MechEngineerDhruv/dep-evtol-digital-twin/Drawings/Load Cell Diagram.png

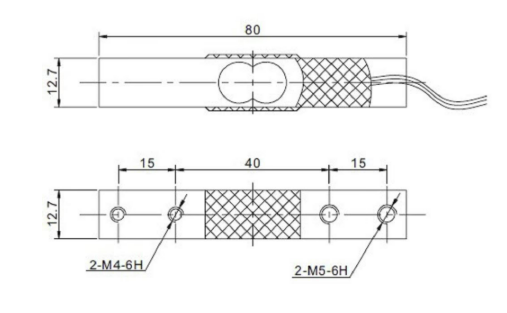
Drawings/Load Cell Diagram.png
