MechEngineerDhruv/dep-evtol-digital-twin/Schematics/ESP32 Pinouts.jpg

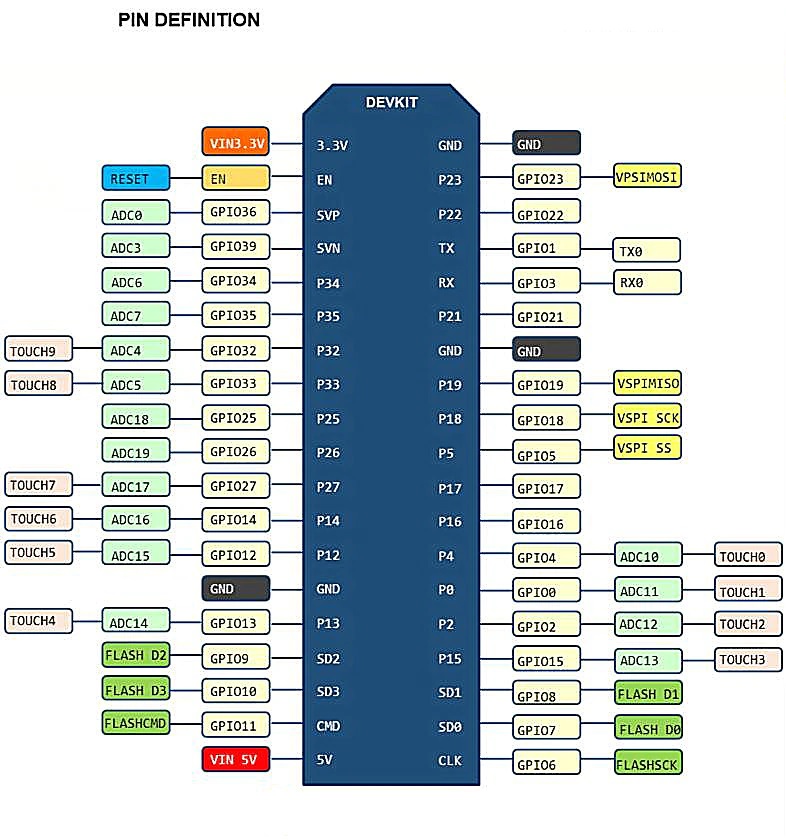
Schematics/ESP32 Pinouts.jpg
