MechEngineerDhruv/dep-evtol-digital-twin/Schematics/Load Cell Connections .png

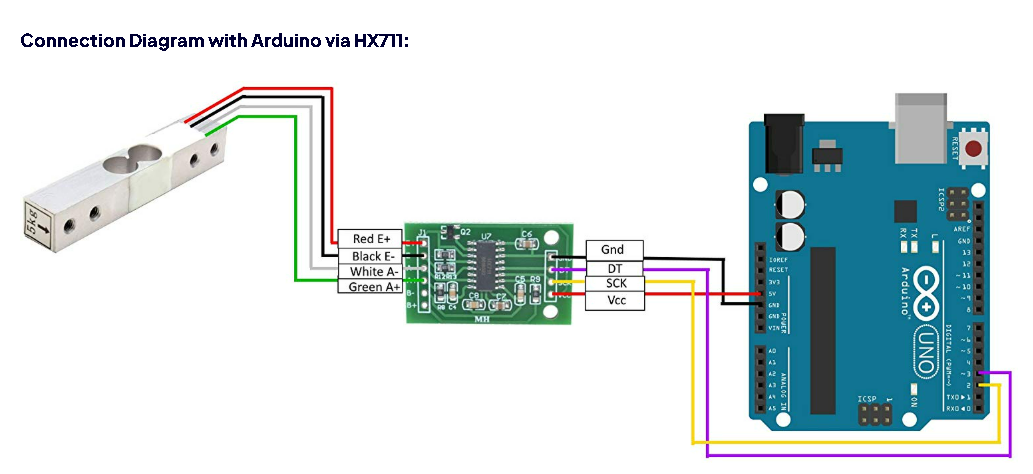
Schematics/Load Cell Connections .png
