MechEngineerDhruv/dep-evtol-digital-twin/Schematics/SCH_Main Schematic DTI_1-P1_2026-10-10.png

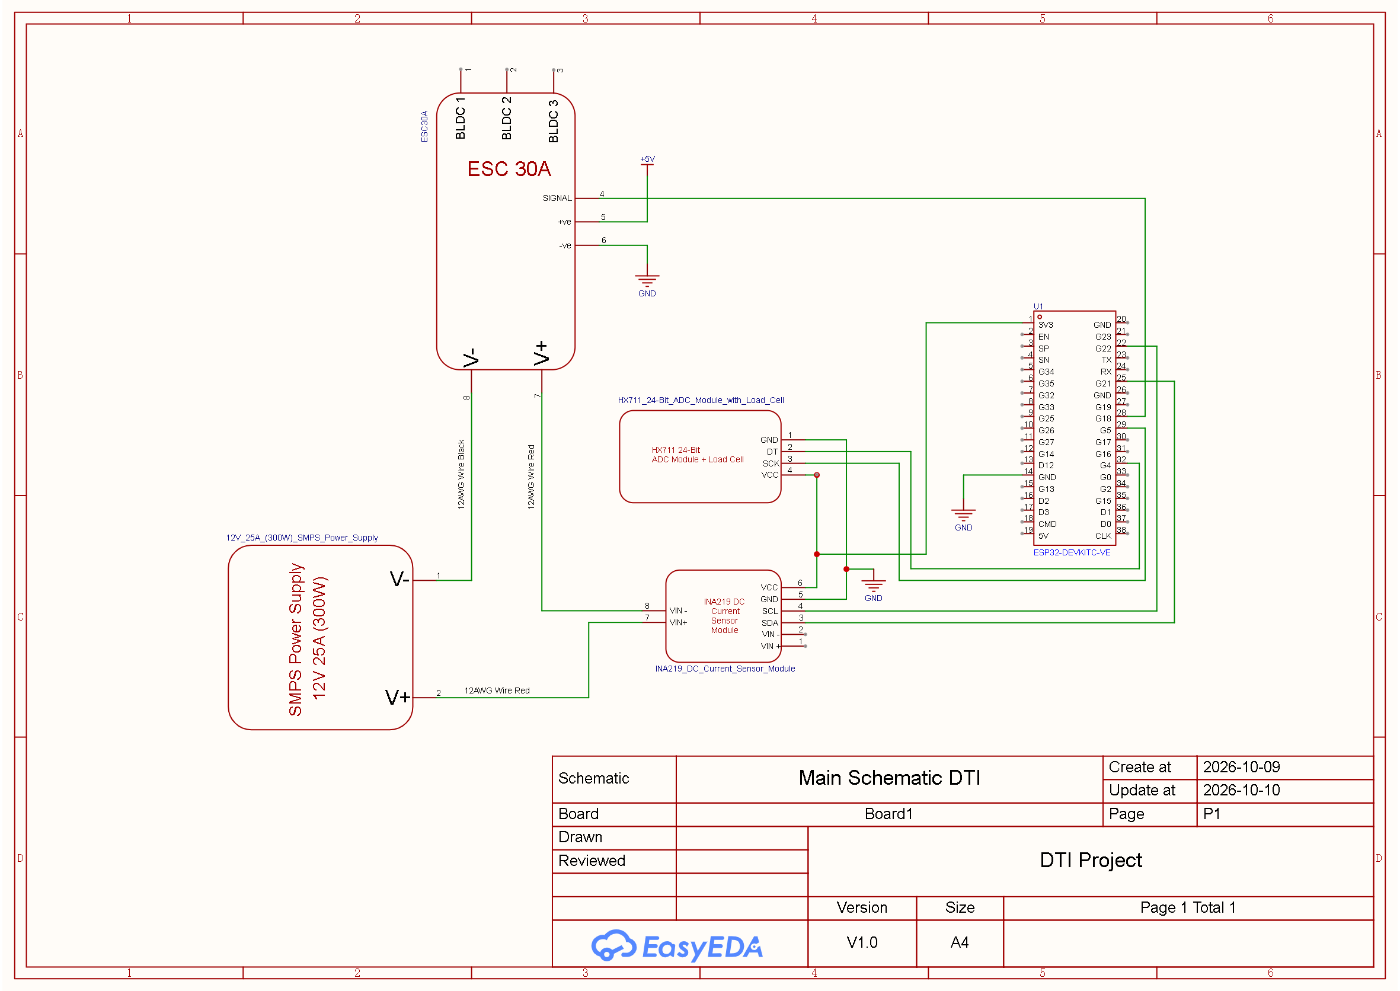
Schematics/SCH_Main Schematic DTI_1-P1_2026-10-10.png
