MechEngineerDhruv/dep-evtol-digital-twin/3D_Model/Full Assembly.step

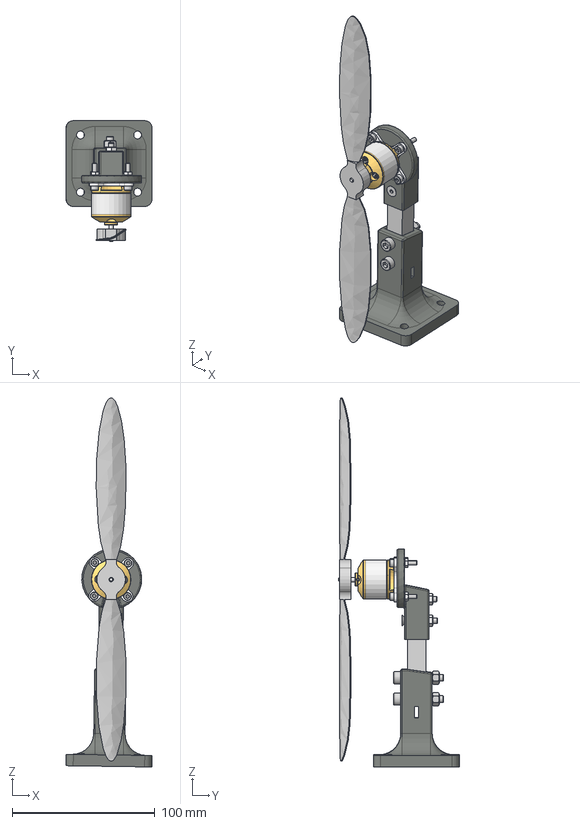
[picture p6: CAD file, 2026-10-29]
3D_Model/Full Assembly.step
60.1 x 84.4 x 258.1 mm
BSHCS ANSI B18.3.1M - M5x0.8 x 30 Steel Grade 2 Plain x 2
HNS2 ANSI B18.2.4.2M - M5x0.8 Steel Grade 2H Plain x 2
BHSFCHCS ANSI B18.3.5M - M4x25 Steel Grade 2 Plain x 2
DIN 934 - M4 x 0.7 Steel 6 Plain x 2
Rotor (1)
Magnet
Shaft
Grub Screw
C Clip
Stator (1)
Coil
Base
Bearing
Bearing (1)
Mount
Screw
Screw (2)
Screw (3)
Screw (1)
ISO 4762 - M3 x 16 Steel 4.6 Plain x 4
ISO 4032 - M3 Steel 6 Plain x 4
Hélice_1045
