MechEngineerDhruv/dep-evtol-digital-twin/3D_Model/Hélice_1045.SLDPRT

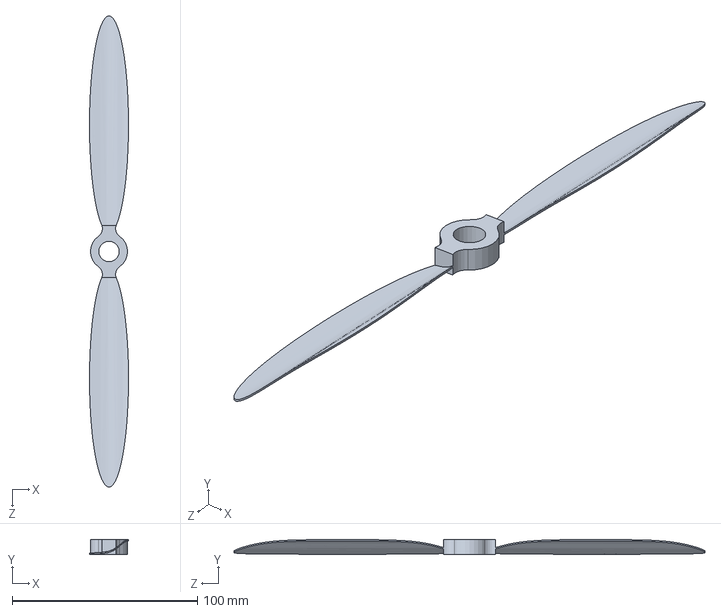
[picture p7: CAD file, 2026-10-29]
3D_Model/Hélice_1045.SLDPRT
21.1 x 8.00 x 254.0 mm
