MechEngineerDhruv/dep-evtol-digital-twin/3D_Model/Bottom Stand.stl

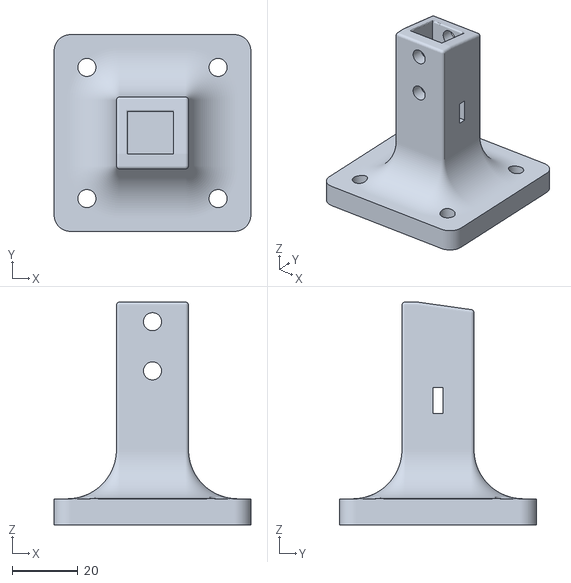
[picture p8: CAD file, 2026-10-18]
3D_Model/Bottom Stand.stl
60.0 x 60.0 x 68.0
