MechEngineerDhruv/dep-evtol-digital-twin/3D_Model/Motor Mount.stl

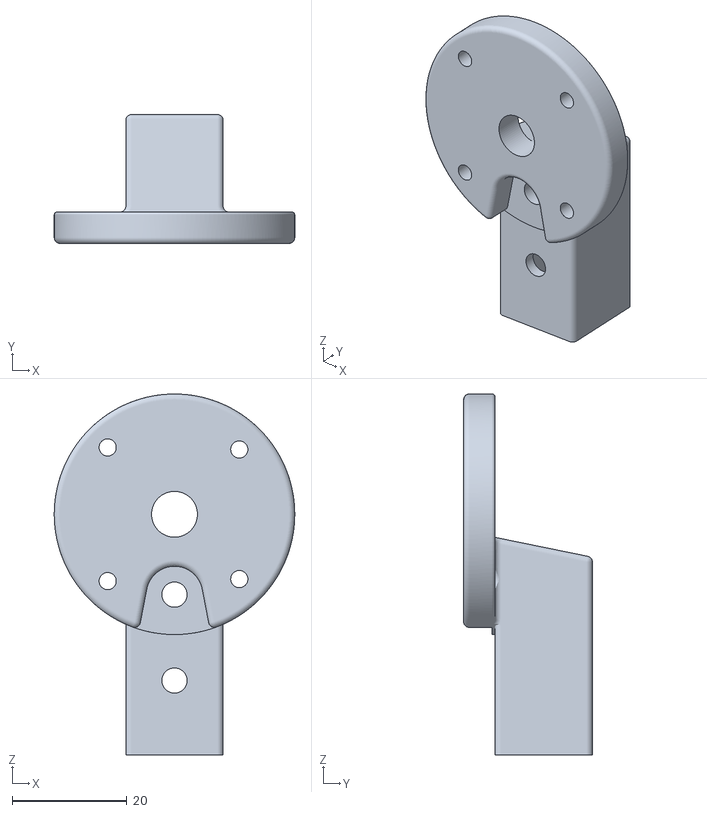
[picture p9: CAD file, 2026-10-18]
3D_Model/Motor Mount.stl
42.0 x 22.5 x 63.0
