MechEngineerDhruv/dep-evtol-digital-twin/(list of files, cad)

Other CAD files:
3D_Model/Assembly.f3z
3D_Model/Bottom Stand.f3z
3D_Model/Full Assembly.f3z
3D_Model/Motor Mount.f3d
