MechEngineerDhruv/dep-evtol-digital-twin/Drawings/Assembly.png

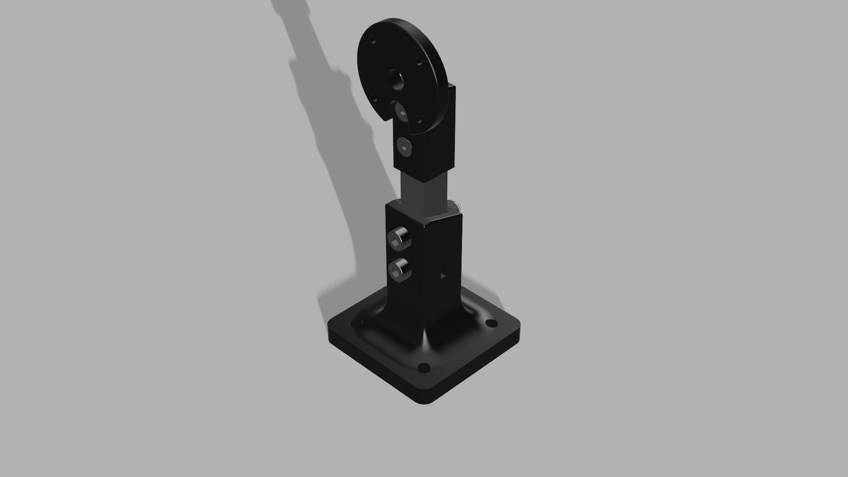
Drawings/Assembly.png
