MechEngineerDhruv/dep-evtol-digital-twin/Full Assembly Rendring .jpg

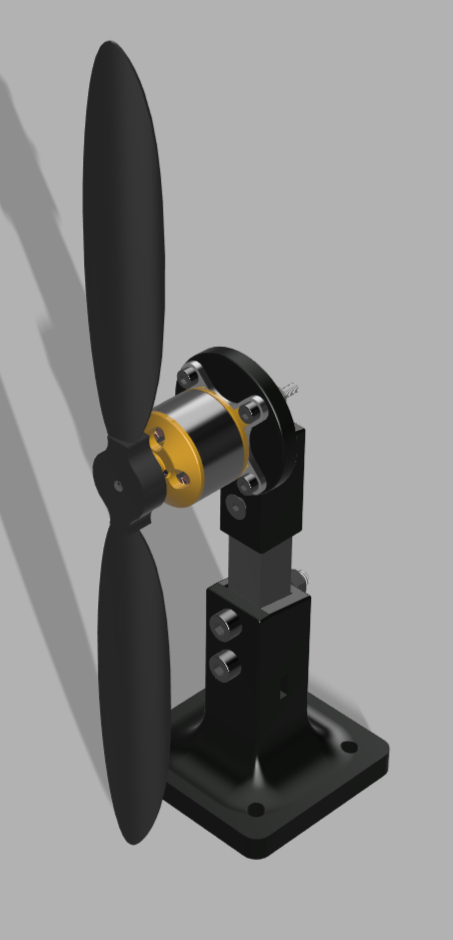
Full Assembly Rendring .jpg
