MechEngineerDhruv/dep-evtol-digital-twin/Drawings/Full Assembly Drawing.pdf

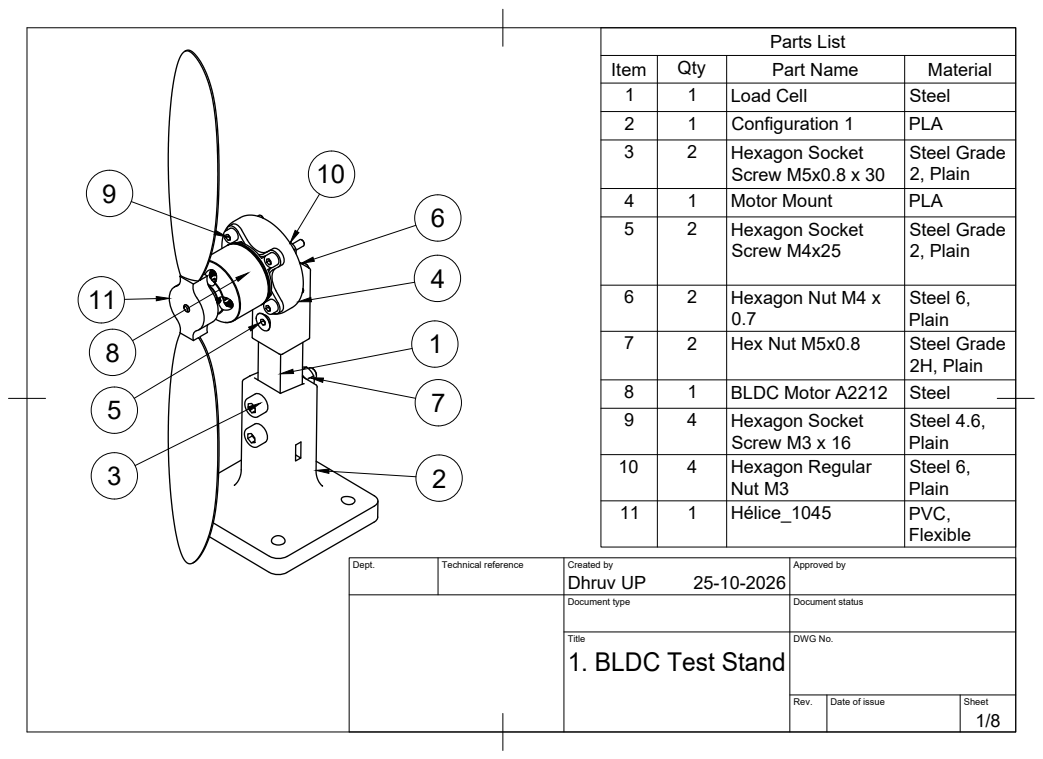
[picture p12: page 1]
Parts List; Flexible 2 58

Item | Qty 2 1 1 | Hexagon Socket Load Cell Configuration 1 Part Name | PLA 3 Steel 2 Material 1

Screw M5x0.8 x 30 | Steel Grade

2 1 | Hexagon Socket Motor Mount | PLA 5 2, Plain 4

2 | Hexagon Nut M4 x Screw M4x25 | Steel Grade 2, Plain 6

2 | Hex Nut M5x0.8 0.7 | Steel 6, Plain 7 Steel Grade

4 1 | Hexagon Socket BLDC Motor A2212 | Steel 9 2H, Plain 8

Screw M3 x 16 | Steel 4.6, Plain

10 | 4 | Hexagon Regular Nut M3 | Steel 6, Plain

11 | 1 | Hélice_1045 | PVC,

Dept. | Technical reference | Created by Dhruv UP 25-10-2026 | Approved by

Document type | Document status

Title 1. BLDC Test Stand | DWG No.

Rev. | Date of issue | Sheet

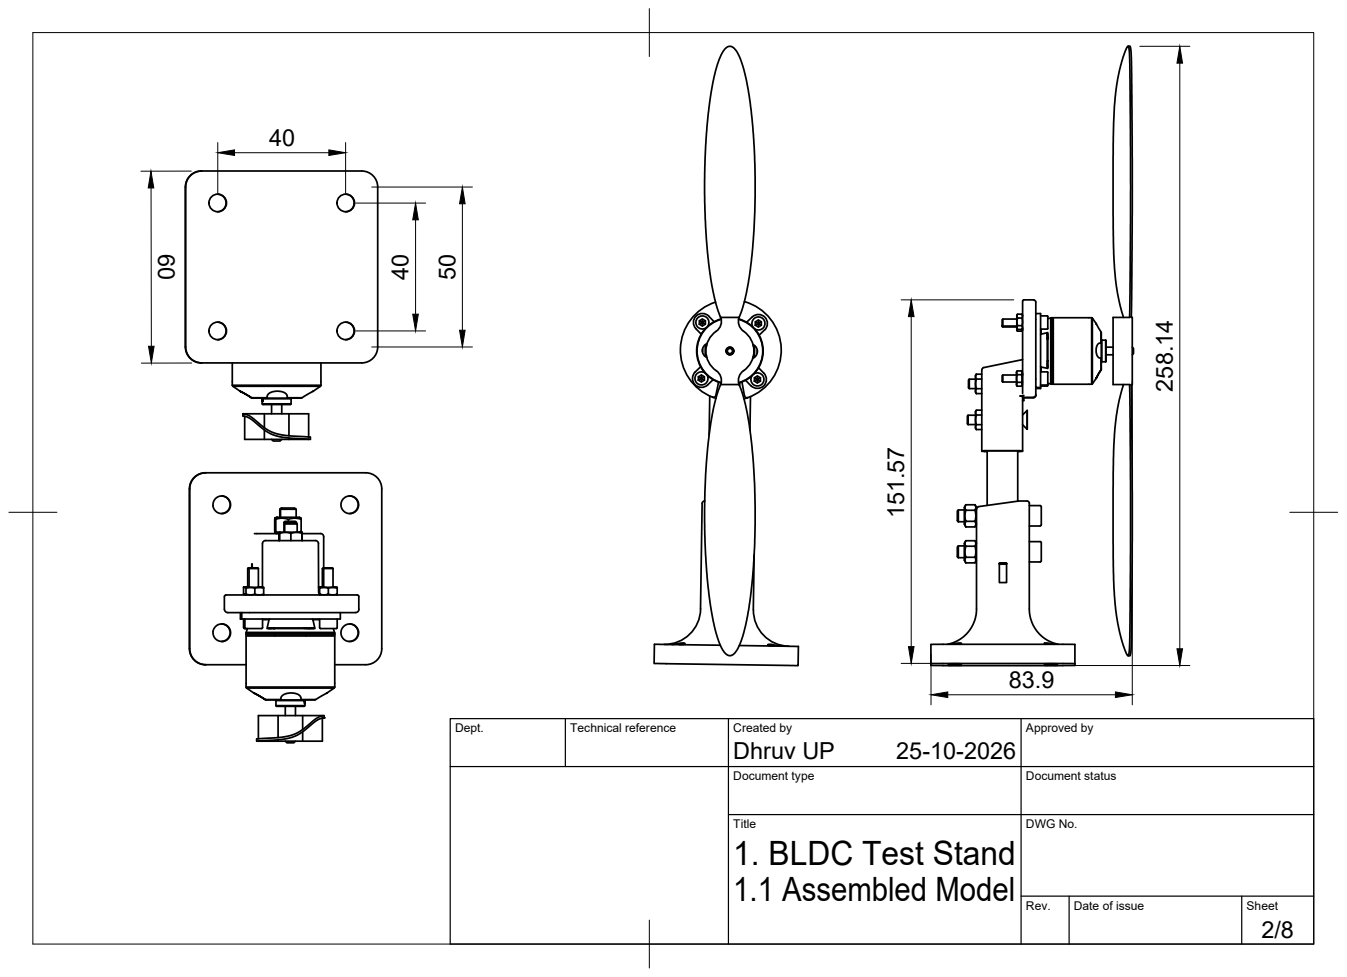
[picture p13: page 2]
Dhruv UP

Dept. | Technical reference | Created by 25-10-2026 | Approved by

Document type | Document status

Title 1. BLDC Test Stand 1.1 Assembled Model | DWG No.

Rev. | Date of issue | Sheet

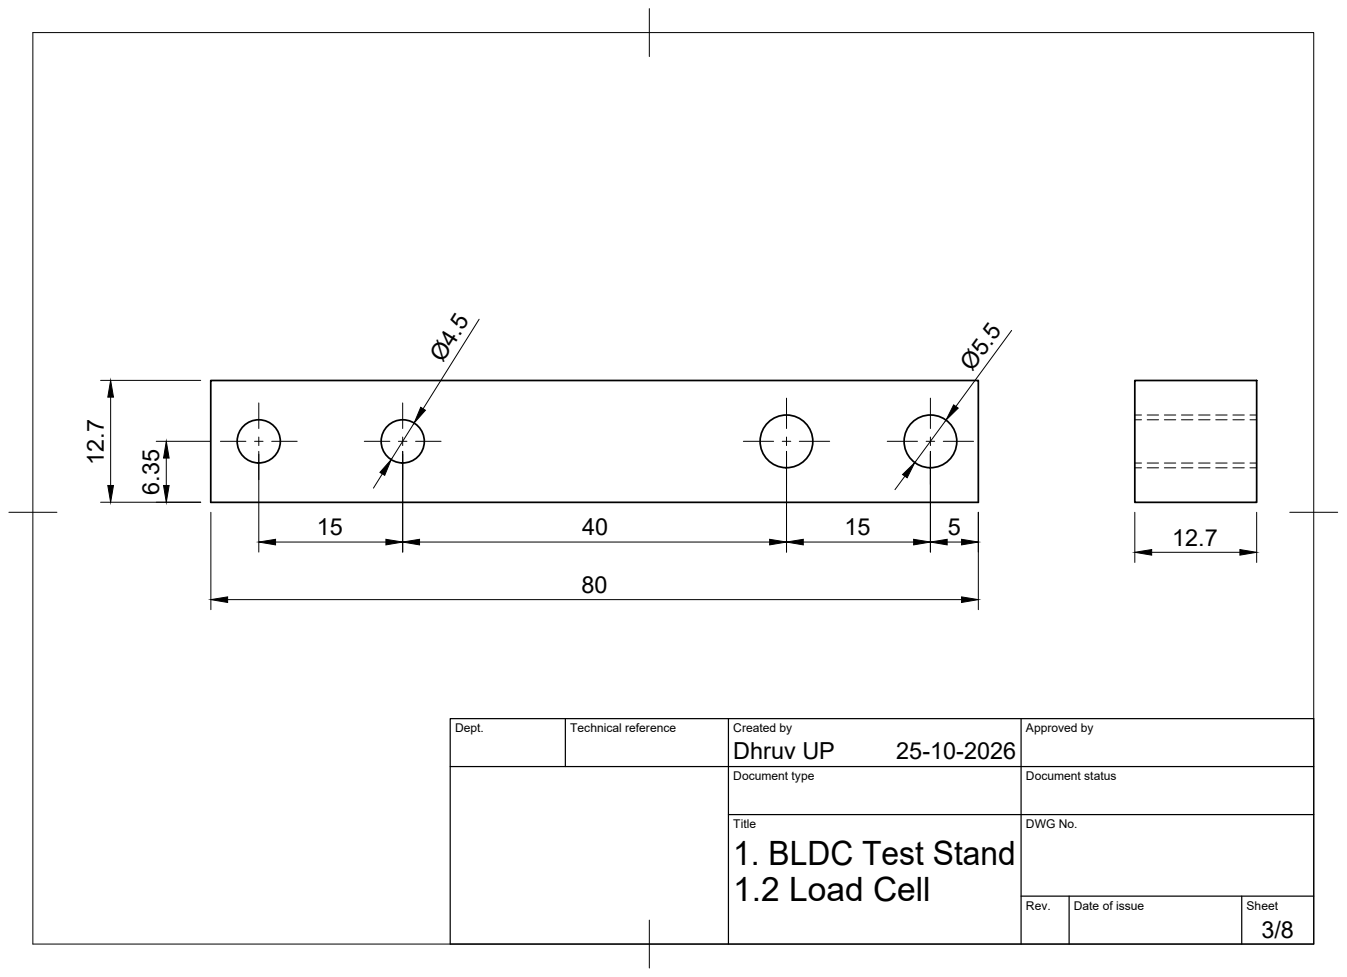
[picture p14: page 3]

Dept. | Technical reference | Created by Dhruv UP 25-10-2026 | Approved by

Document type | Document status

Title 1. BLDC Test Stand 1.2 Load Cell | DWG No.

Rev. | Date of issue | Sheet

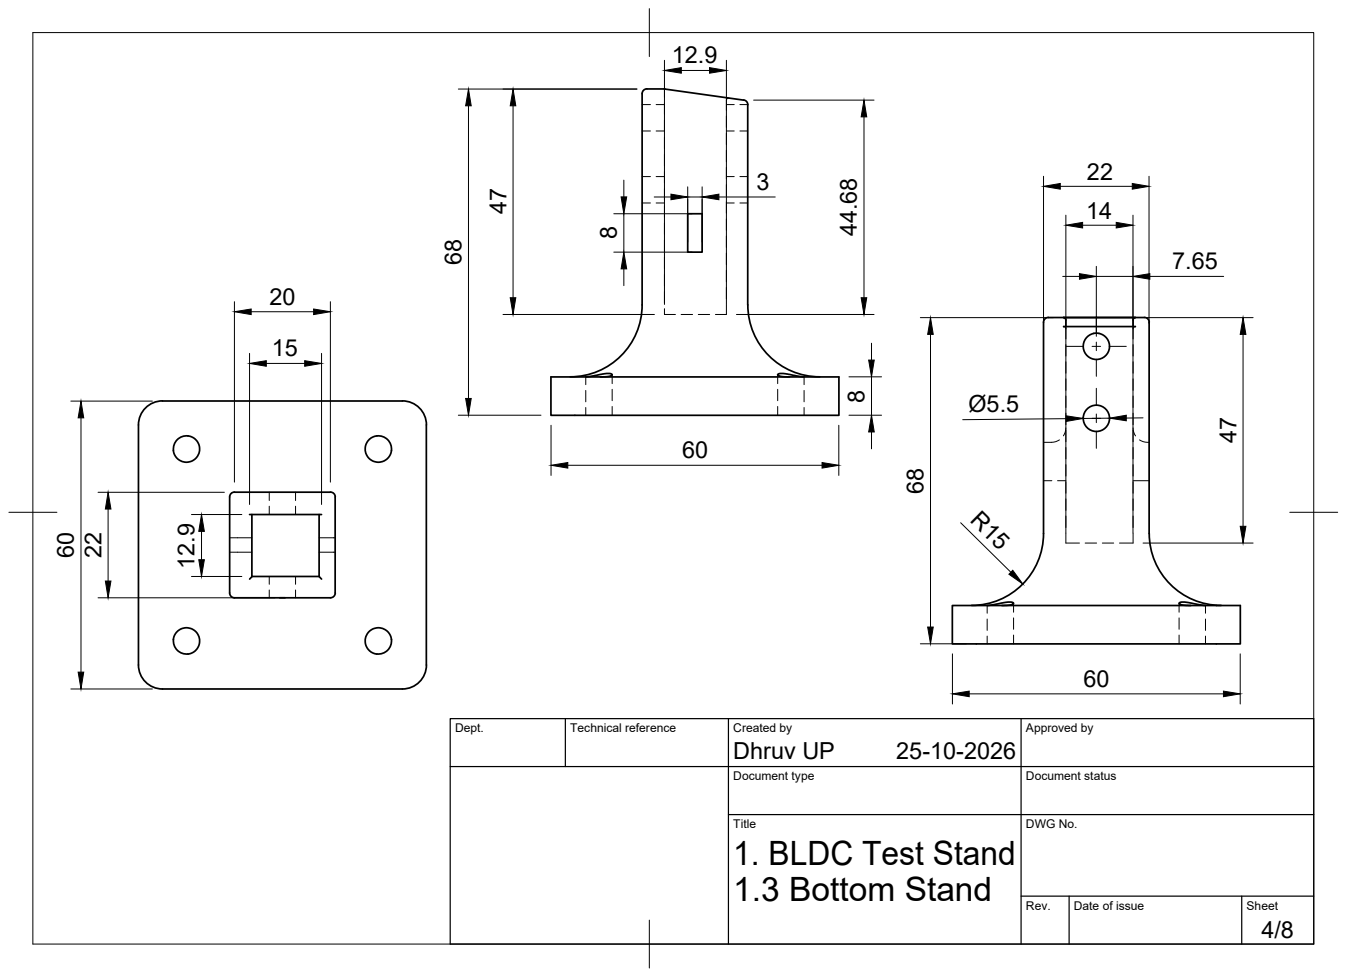
[picture p15: page 4]

Dept. | Technical reference | Created by Dhruv UP 25-10-2026 | Approved by

Document type | Document status

Title 1. BLDC Test Stand 1.3 Bottom Stand | DWG No.

Rev. | Date of issue | Sheet

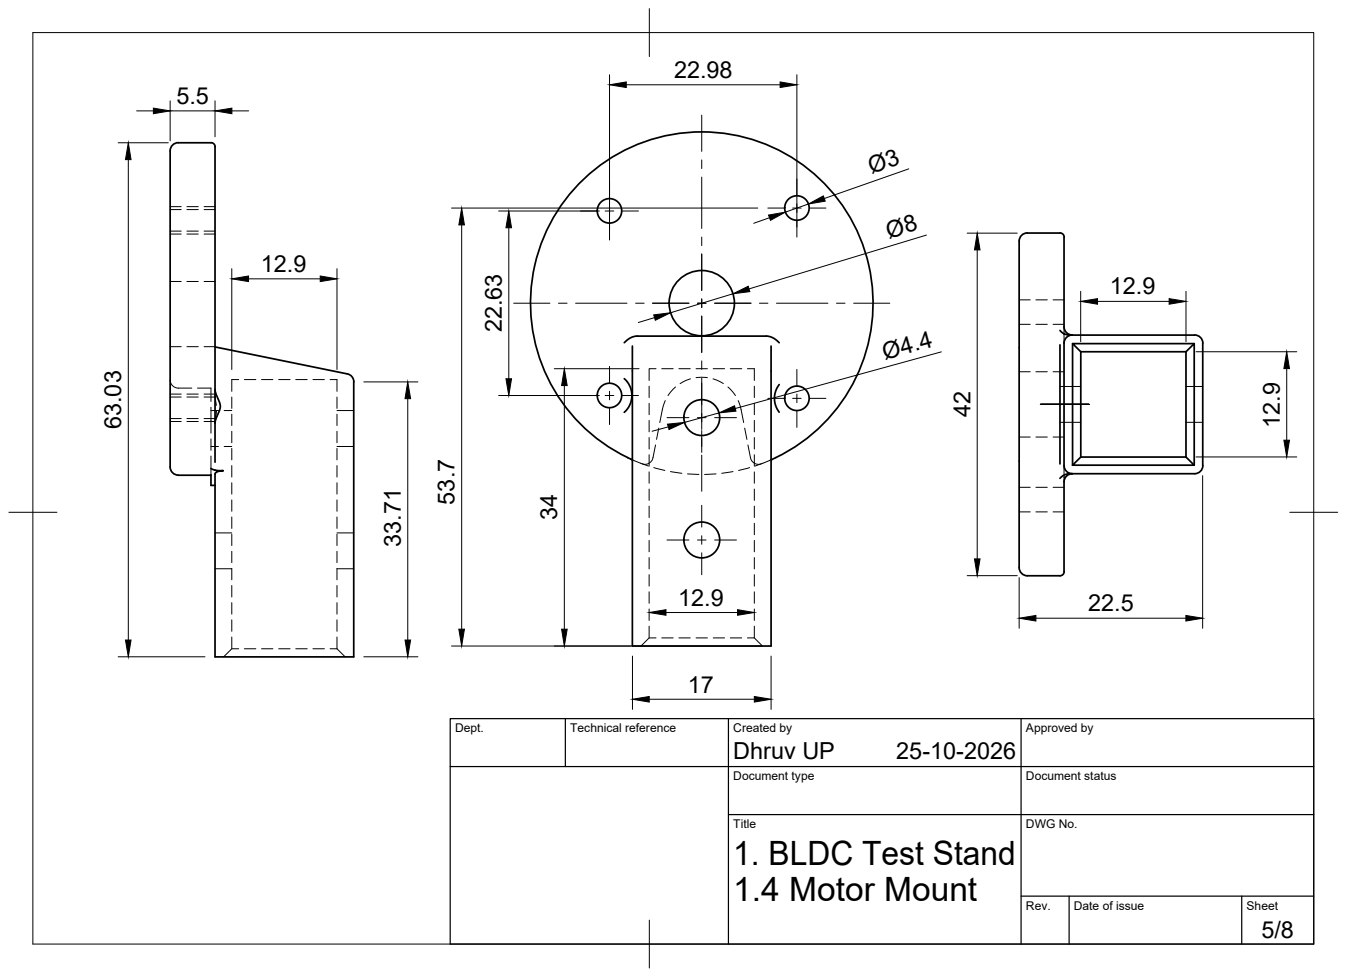
[picture p16: page 5]
Dhruv UP 53.7

Dept. | Technical reference | Created by 25-10-2026 | Approved by

Document type | Document status

Title 1. BLDC Test Stand 1.4 Motor Mount | DWG No.

Rev. | Date of issue | Sheet

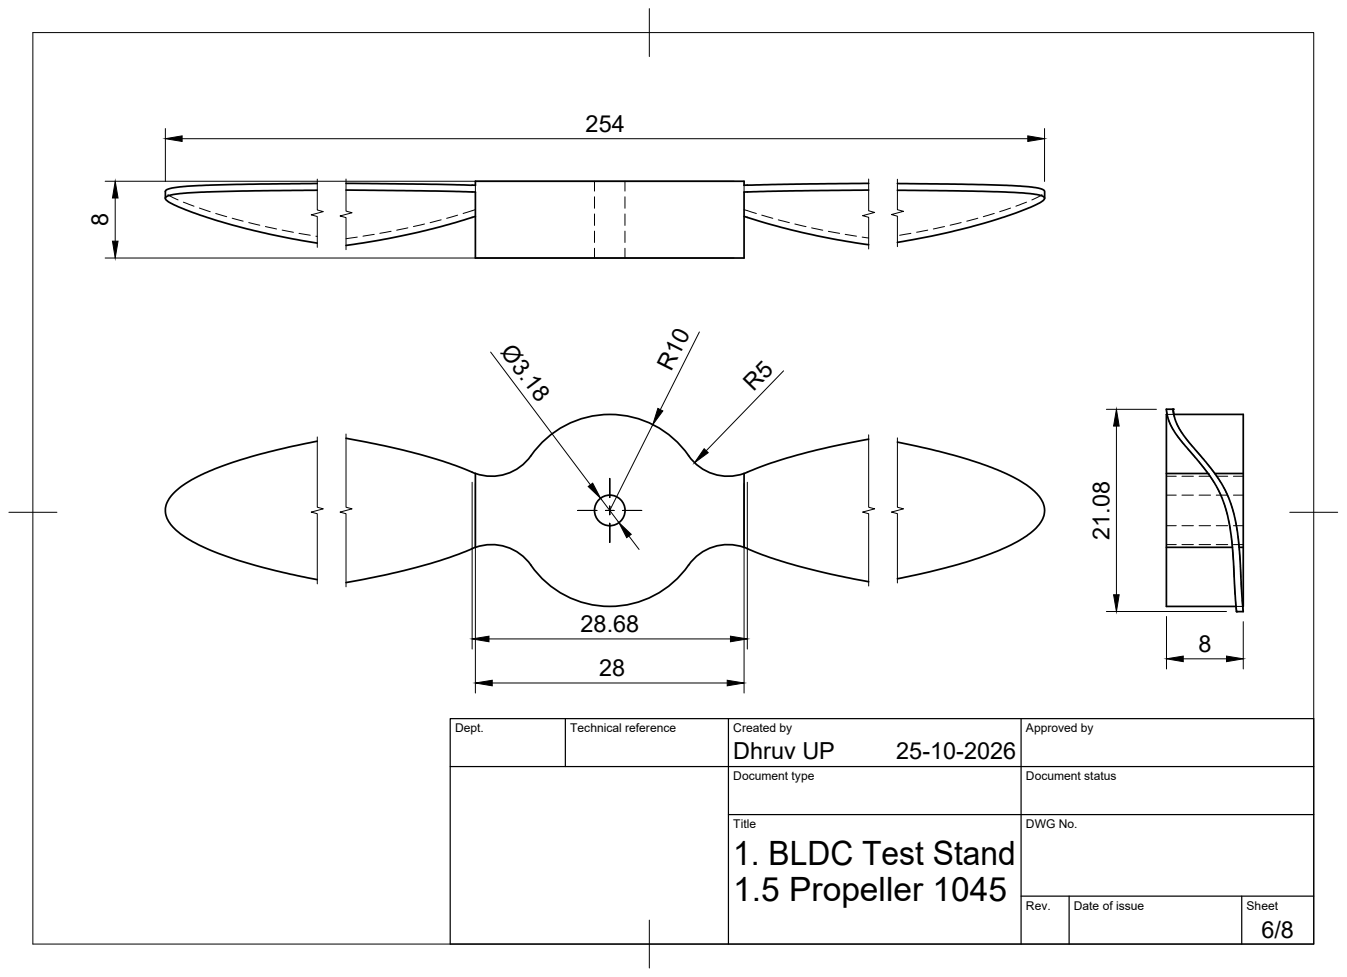
[picture p17: page 6]

Dept. | Technical reference | Created by Dhruv UP 25-10-2026 | Approved by

Document type | Document status

Title 1. BLDC Test Stand 1.5 Propeller 1045 | DWG No.

Rev. | Date of issue | Sheet

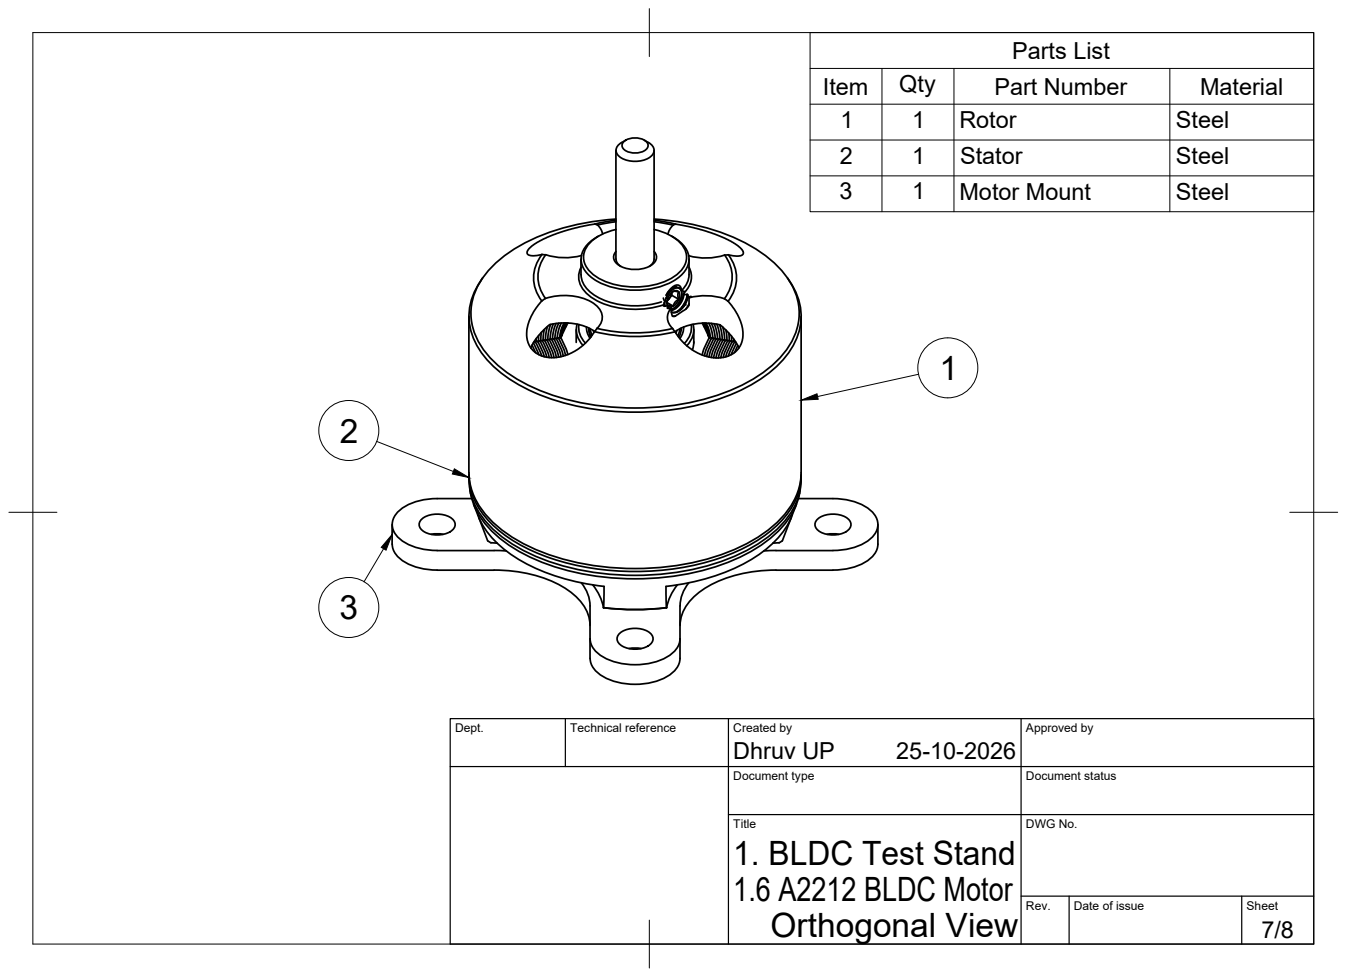
[picture p18: page 7]
Parts List

Item | Qty | Part Number | Material
1 | 1 | Rotor | Steel
2 | 1 | Stator | Steel
3 | 1 | Motor Mount | Steel

Dept. | Technical reference | Created by Dhruv UP 25-10-2026 | Approved by

Document type | Document status

Title 1. BLDC Test Stand 1.6 A2212 BLDC Motor Orthogonal View | DWG No.

Rev. | Date of issue | Sheet

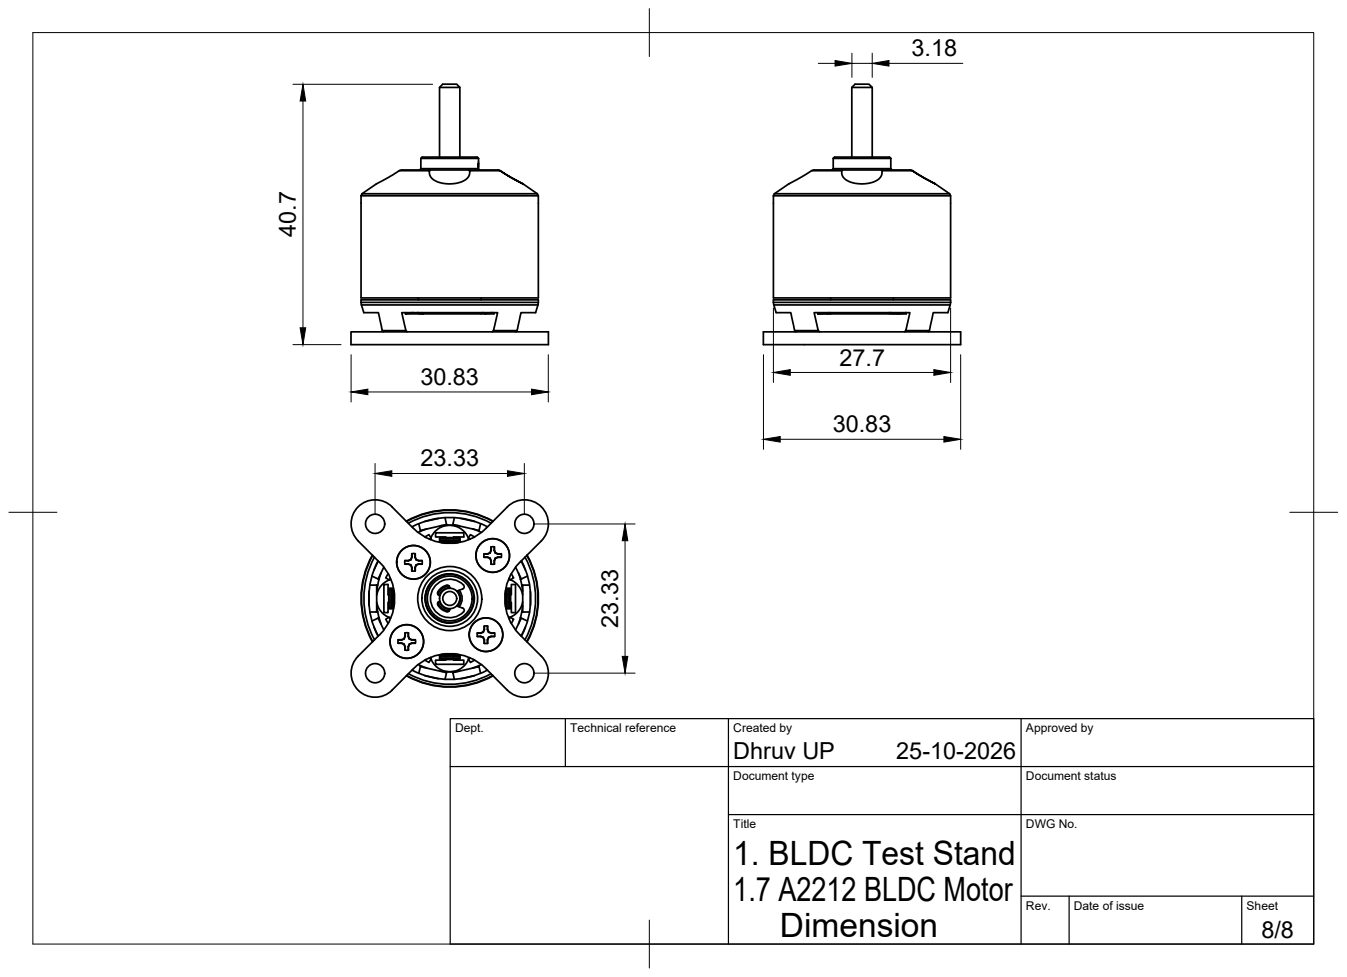
[picture p19: page 8]

Dept. | Technical reference | Created by Dhruv UP 25-10-2026 | Approved by

Document type | Document status

Title 1. BLDC Test Stand 1.7 A2212 BLDC Motor Dimension | DWG No.

Rev. | Date of issue | Sheet
