MechEngineerDhruv/dep-evtol-digital-twin/Schematics/SCH_Main Schematic DTI_2026-10-10.pdf

# ESC 30A BLDC ² ²

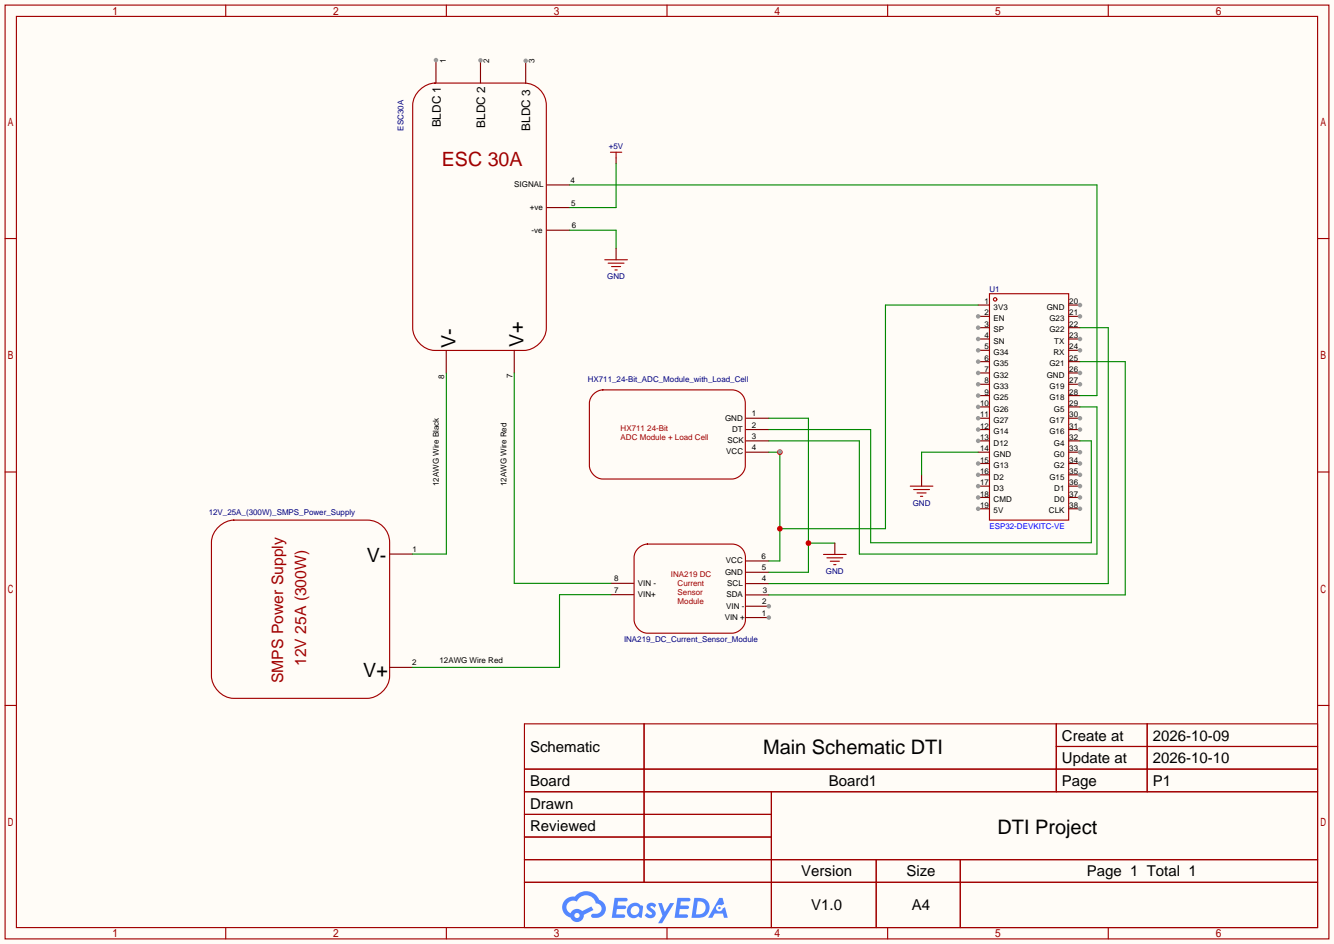
[picture p20: page 1]

HX711 24-Bit
ADC Module + Load Cell

Schematic | Main Schematic DTI | Create at | 2026-10-09

Update at | 2026-10-10

Board | Board1 | Page | P1
Drawn | | DTI Project
Reviewed

Version | Size | Page 1 Total 1
V1.0 | A4
