MechEngineerDhruv/dep-evtol-digital-twin/Drawings/Assembly Drawing Updated.pdf

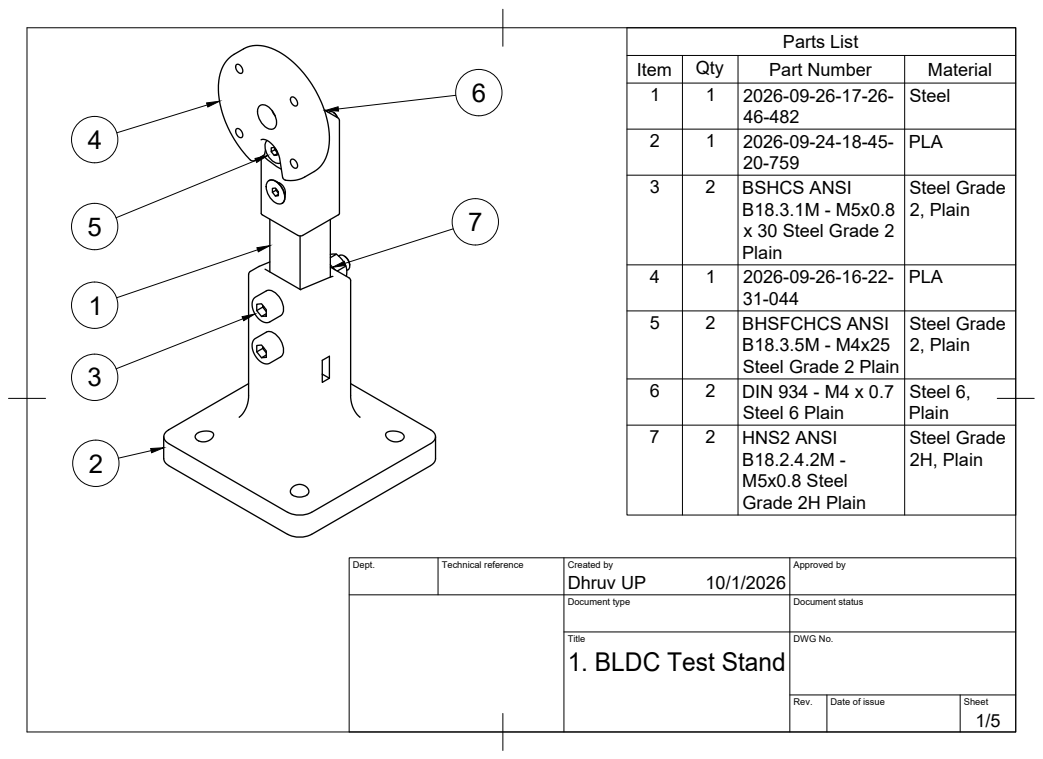
[picture p21: page 1]
Parts List; Steel Grade 2; 2H, Plain 3

Item | Qty 1 | 2026-09-26-17-26-Part Number | Material 1
1 | 2026-09-24-18-45-46-482 | Steel 2

2 | BSHCS ANSI 20-759 | PLA 3

1 | B18.3.1M - M5x0.8 2026-09-26-16-22-x 30 Steel Grade 2 Plain | Steel Grade 2, Plain 4

2 | BHSFCHCS ANSI 31-044 | PLA 5

2 | DIN 934 - M4 x 0.7 B18.3.5M - M4x25 Steel Grade 2 Plain | Steel Grade 2, Plain 6

2 | HNS2 ANSI Steel 6 Plain | Steel 6, Plain 7

B18.2.4.2M -M5x0.8 Steel Grade 2H Plain

Dept. | Technical reference | Created by Dhruv UP 10/1/2026 | Approved by

Document type | Document status

Title 1. BLDC Test Stand | DWG No.

Rev. | Date of issue | Sheet

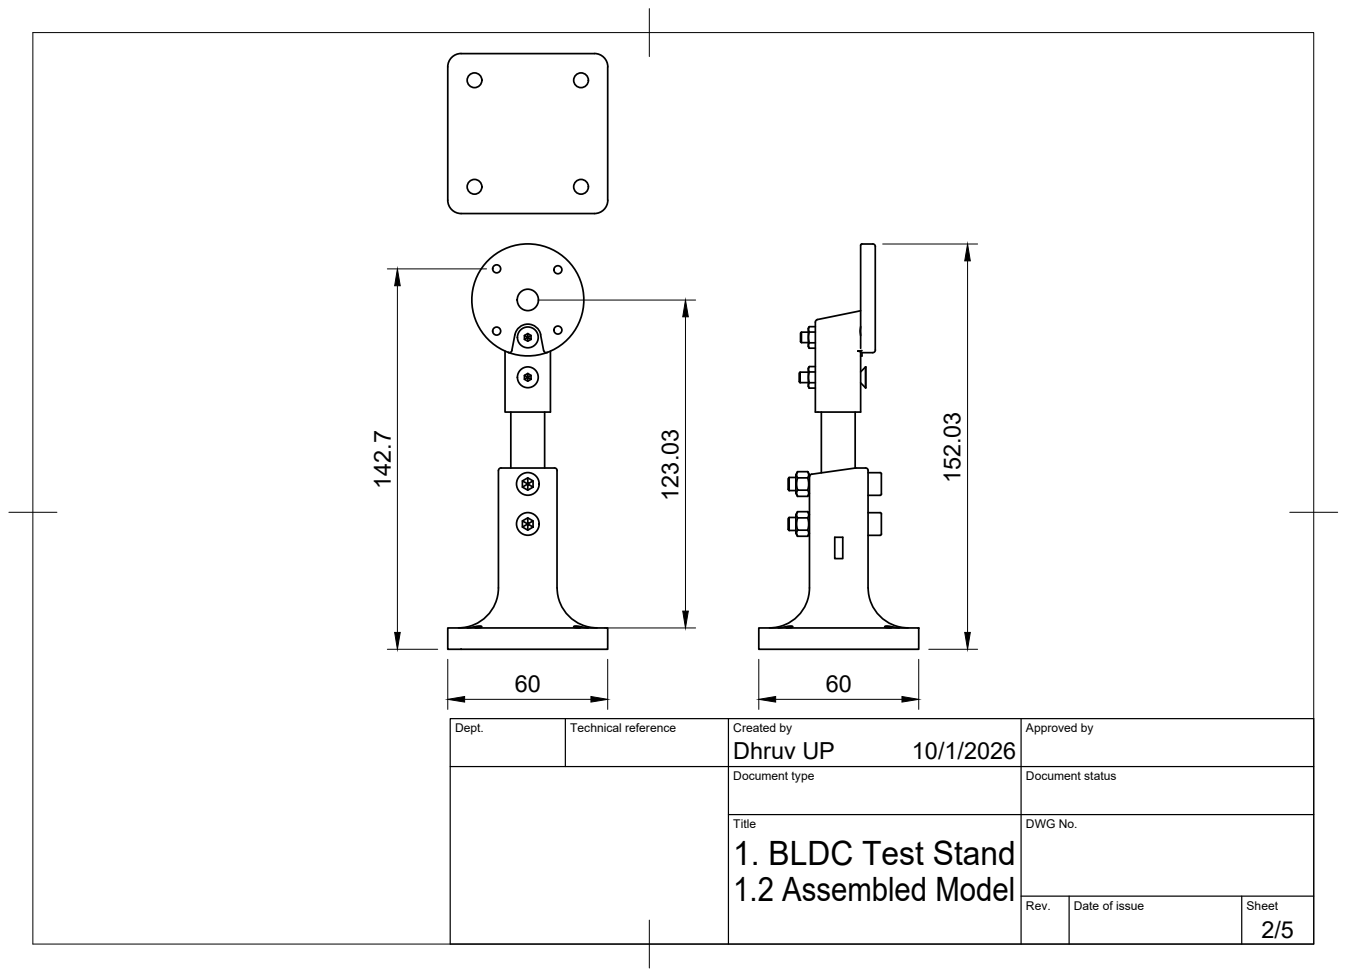
[picture p22: page 2]

Dept. | Technical reference | Created by Dhruv UP 10/1/2026 | Approved by

Document type | Document status

Title 1. BLDC Test Stand 1.2 Assembled Model | DWG No.

Rev. | Date of issue | Sheet

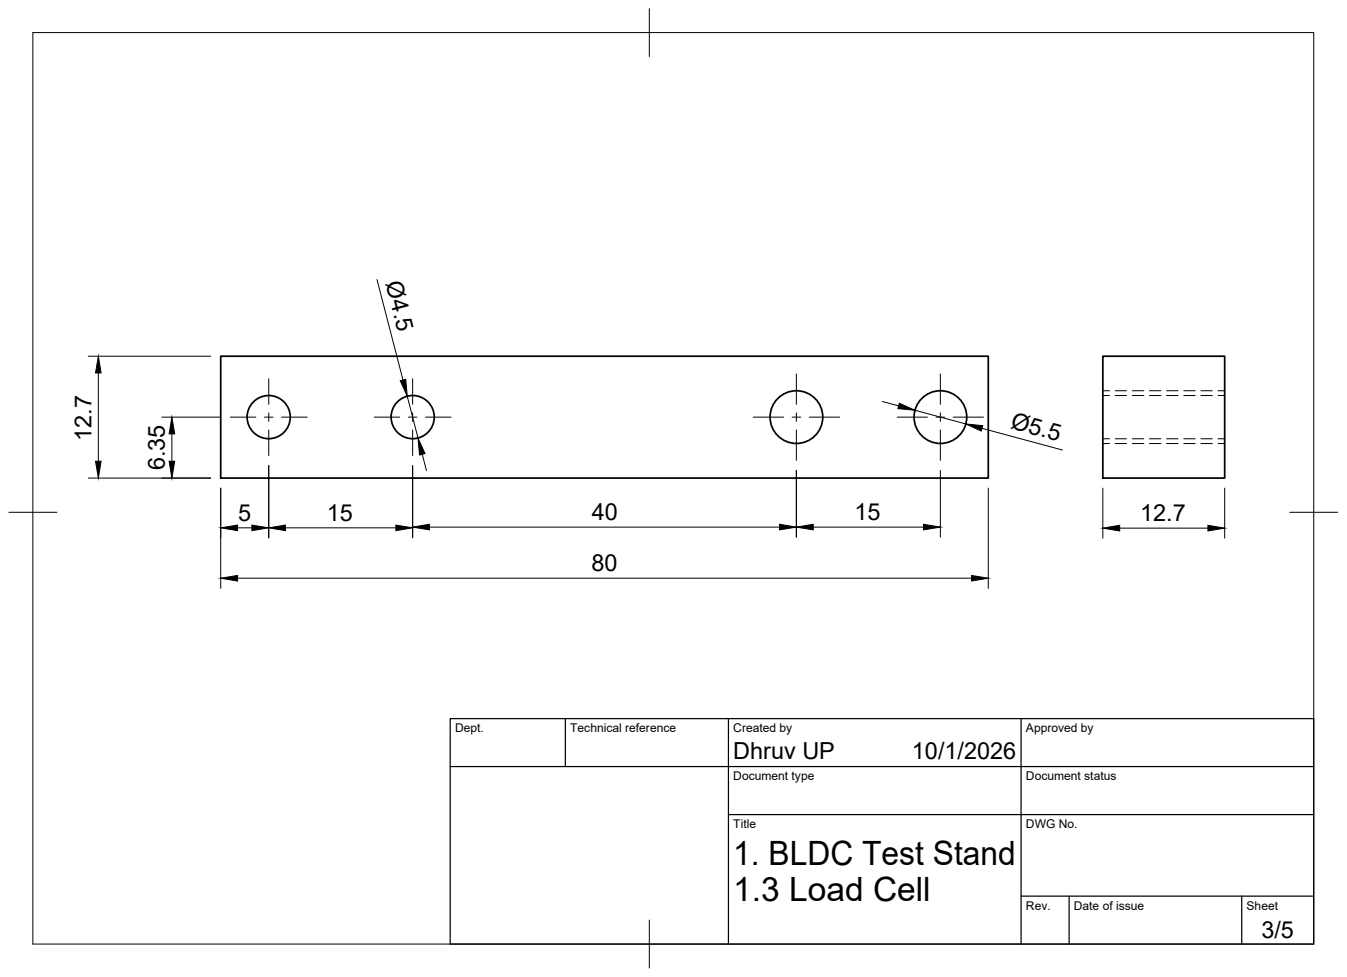
[picture p23: page 3]

Dept. | Technical reference | Created by Dhruv UP 10/1/2026 | Approved by

Document type | Document status

Title 1. BLDC Test Stand 1.3 Load Cell | DWG No.

Rev. | Date of issue | Sheet

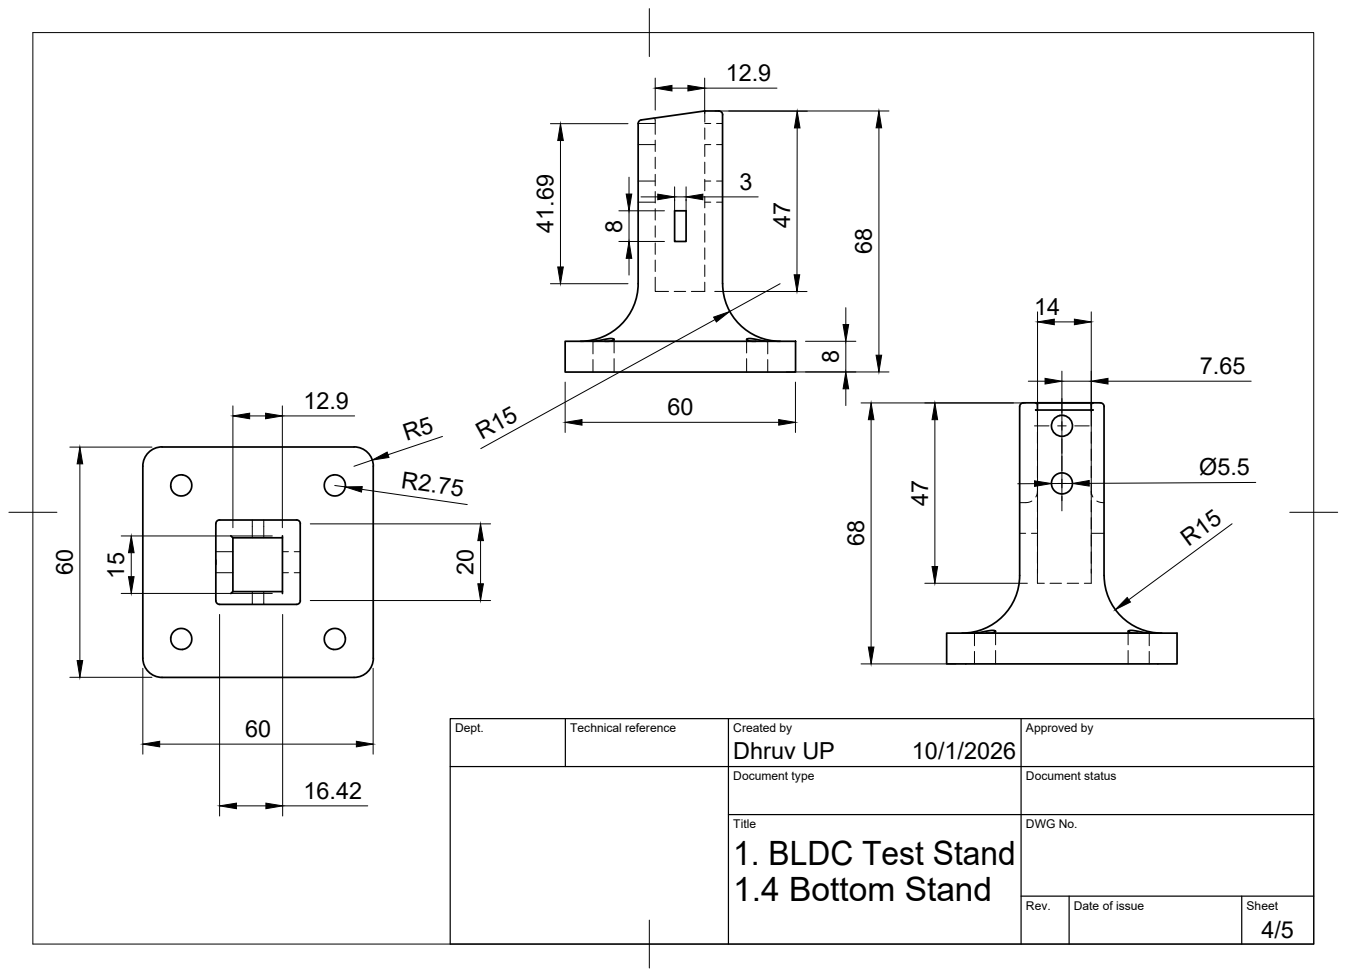
[picture p24: page 4]

Dept. | Technical reference | Created by Dhruv UP 10/1/2026 | Approved by

Document type | Document status

Title 1. BLDC Test Stand 1.4 Bottom Stand | DWG No.

Rev. | Date of issue | Sheet

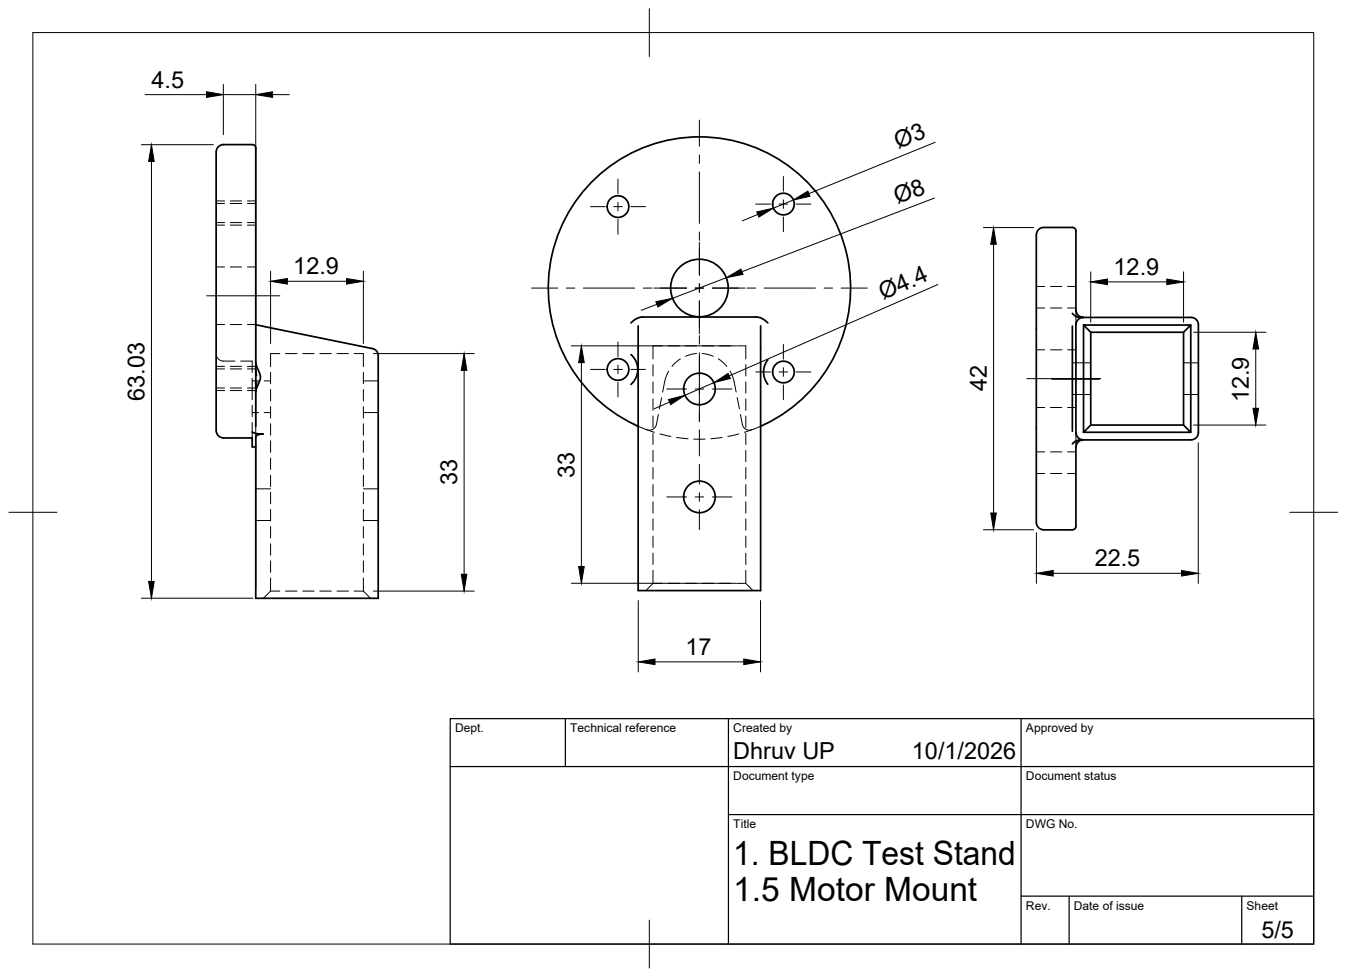
[picture p25: page 5]
Dhruv UP

Dept. | Technical reference | Created by 10/1/2026 | Approved by

Document type | Document status

Title 1. BLDC Test Stand 1.5 Motor Mount | DWG No.

Rev. | Date of issue | Sheet
