MechEngineerDhruv/dep-evtol-digital-twin/Python_Code/Main_Code_5.py

# ========================================================================
# Includes Polynomial Regression, Calibration of load cell, MQTT Broker
# and a dedicated Connect Button for ESP32
# ========================================================================
import streamlit as st
import paho.mqtt.client as mqtt
import serial
import pandas as pd
import json
import time
import numpy as np
import plotly.graph_objects as go
from plotly.subplots import make_subplots

# ==========================================
# 1. PAGE CONFIGURATION & CUSTOM CSS
# ==========================================
st.set_page_config(page_title="DEP Digital Twin", layout="wide", initial_sidebar_state="expanded")

st.markdown("""
    <style>
    div[data-testid="metric-container"] {
        background-color: #1E1E1E;
        border: 1px solid #333;
        padding: 15px;
        border-radius: 8px;
        box-shadow: 0 4px 6px rgba(0, 0, 0, 0.3);
    }
    </style>
""", unsafe_allow_html=True)

st.title("🚁 DEP Digital Twin Analytics Engine")
st.markdown("Real-time Bidirectional Cyber-Physical Telemetry Dashboard")

# ==========================================
# 2. STATE MANAGEMENT
# ==========================================
if 'data' not in st.session_state:
    st.session_state.data = pd.DataFrame(
        columns=['time_s', 'thrust_g', 'voltage', 'current_A', 'power_W', 'pwm', 'efficiency_g_W'])
if 'start_millis' not in st.session_state:
    st.session_state.start_millis = None
if 'is_running' not in st.session_state:
    st.session_state.is_running = False
# --- NEW CODE: Add connection state tracking ---
if 'is_connected' not in st.session_state:
    st.session_state.is_connected = False
# -----------------------------------------------

# ==========================================
# 3. SIDEBAR CONTROL PANEL
# ==========================================
st.sidebar.header("⚙️ System Control")
serial_port = st.sidebar.text_input("COM Port", value="COM6")
baud_rate = st.sidebar.selectbox("Baud Rate", [115200, 9600, 57600], index=0)

# --- NEW CODE: Separate Connect Button to Verify ESP32 COM Port ---
if st.sidebar.button("🔌 Connect to ESP32", use_container_width=True):
    try:
        # Briefly open and close the port to verify it is available and not locked
        test_ser = serial.Serial(serial_port, baud_rate, timeout=0.1)
        test_ser.close()
        st.session_state.is_connected = True
        st.sidebar.success(f"✅ Successfully connected to {serial_port}")
    except Exception as e:
        st.session_state.is_connected = False
        st.sidebar.error(f"❌ Connection Failed: {e}")
# ------------------------------------------------------------------

st.sidebar.markdown("---")
st.sidebar.subheader("✈️ Flight Controls")

if st.sidebar.button("🚨 EMERGENCY STOP", type="primary", use_container_width=True):
    target_pwm = 1000
    st.session_state.is_running = False
    try:
        emergency_ser = serial.Serial()
        emergency_ser.port = serial_port
        emergency_ser.baudrate = baud_rate
        emergency_ser.setDTR(False)
        emergency_ser.setRTS(False)
        emergency_ser.open()

        # Send emergency kill JSON
        cmd = {"pwm": 1000, "cal": 1.0, "tare": 0}
        emergency_ser.write((json.dumps(cmd) + '\n').encode())
        emergency_ser.close()
        st.sidebar.success("E-STOP TRIGGERED. Motor Disarmed.")
    except Exception as e:
        st.sidebar.error(f"E-Stop Comms Failure: {e}")
else:
    target_pwm = st.sidebar.slider("Throttle Override (PWM)", min_value=1000, max_value=2000, value=1000, step=10)

st.sidebar.markdown("---")
st.sidebar.subheader("⚖️ Load Cell Calibration")

# Live Calibration Factor Input
cal_factor = st.sidebar.number_input("Calibration Factor", value=1.0, step=1.0, format="%.2f")

# Tare Button Logic with Safety Lock
tare_requested = st.sidebar.button("Zero / Tare Scale", use_container_width=True)
if tare_requested:
    if target_pwm > 1000:
        st.sidebar.error("❌ Motor must be OFF (1000 PWM) to tare the scale.")
        tare_requested = False
    else:
        st.sidebar.warning("Taring Scale... (Please wait 2 seconds)")

st.sidebar.markdown("---")

# --- EDITED CODE: Enforce COM connection before allowing Telemetry Link to Start ---
if st.sidebar.button("▶️ Start Telemetry Link", use_container_width=True):
    if st.session_state.is_connected:
        st.session_state.is_running = True
    else:
        st.sidebar.error("⚠️ Please click 'Connect to ESP32' first!")

if st.sidebar.button("⏹️ Stop Link", use_container_width=True):
    st.session_state.is_running = False
# -----------------------------------------------------------------------------------

# ==========================================
# 4. UI LAYOUT PLACEHOLDERS
# ==========================================
kpi_col1, kpi_col2, kpi_col3, kpi_col4 = st.columns(4)
metric_thrust = kpi_col1.empty()
metric_power = kpi_col2.empty()
metric_current = kpi_col3.empty()
metric_efficiency = kpi_col4.empty()

st.markdown("---")
chart_col1, chart_col2 = st.columns(2)
with chart_col1:
    transient_chart = st.empty()
    thrust_curve_chart = st.empty()
with chart_col2:
    electrical_chart = st.empty()
    efficiency_curve_chart = st.empty()


# ==========================================
# 5. CHART GENERATION FUNCTIONS (Unchanged)
# ==========================================
def get_transient_fig(df):
    fig = make_subplots(specs=[[{"secondary_y": True}]])
    fig.add_trace(go.Scatter(x=df['time_s'], y=df['thrust_g'], name='Thrust (g)', mode='lines',
                             line=dict(color='#00F0FF', width=2)), secondary_y=False)
    fig.add_trace(go.Scatter(x=df['time_s'], y=df['power_W'], name='Power (W)', mode='lines',
                             line=dict(color='#FF0055', width=2)), secondary_y=True)
    fig.update_layout(title="Transient Response", template="plotly_dark", height=350, margin=dict(l=0, r=0, t=40, b=0))

    fig.update_yaxes(title_text="Thrust (g)", secondary_y=False)
    fig.update_yaxes(title_text="Power (W)", secondary_y=True)

    return fig


def get_electrical_fig(df):
    fig = make_subplots(specs=[[{"secondary_y": True}]])
    fig.add_trace(go.Scatter(x=df['time_s'], y=df['current_A'], name='Current (A)', mode='lines',
                             line=dict(color='#FFB300', width=2)), secondary_y=False)
    fig.add_trace(go.Scatter(x=df['time_s'], y=df['voltage'], name='Voltage (V)', mode='lines',
                             line=dict(color='#B300FF', width=2)), secondary_y=True)
    fig.update_layout(title="Electrical Health", template="plotly_dark", height=350, margin=dict(l=0, r=0, t=40, b=0))

    fig.update_yaxes(title_text="Current (A)", secondary_y=False)
    fig.update_yaxes(title_text="Voltage (V)", secondary_y=True)

    return fig


def get_thrust_curve_fig(df):
    fig = go.Figure()
    fig.add_trace(go.Scatter(x=df['pwm'], y=df['thrust_g'], mode='markers', name='Live Sensor Data',
                             marker=dict(color='#00F0FF', size=5, opacity=0.5)))
    if len(df['pwm'].unique()) > 3:
        coeffs = np.polyfit(df['pwm'], df['thrust_g'], 2)
        poly_func = np.poly1d(coeffs)
        x_trend = np.linspace(df['pwm'].min(), df['pwm'].max(), 50)
        y_trend = poly_func(x_trend)
        fig.add_trace(go.Scatter(x=x_trend, y=y_trend, mode='lines', name='Regression Curve',
                                 line=dict(color='#FFFFFF', width=3, dash='solid')))
    fig.update_layout(title="Aerodynamic Profile (Thrust Curve)", template="plotly_dark", height=350,
                      margin=dict(l=0, r=0, t=40, b=0), xaxis_title="PWM Signal (us)", yaxis_title="Thrust (g)")
    return fig


def get_efficiency_curve_fig(df):
    fig = go.Figure()
    fig.add_trace(go.Scatter(x=df['pwm'], y=df['efficiency_g_W'], mode='markers', name='Live Sensor Data',
                             marker=dict(color='#00FF44', size=5, opacity=0.5)))
    if len(df['pwm'].unique()) > 3:
        clean_df = df[df['power_W'] > 1.0]
        if len(clean_df['pwm'].unique()) > 3:
            coeffs = np.polyfit(clean_df['pwm'], clean_df['efficiency_g_W'], 2)
            poly_func = np.poly1d(coeffs)
            x_trend = np.linspace(clean_df['pwm'].min(), clean_df['pwm'].max(), 50)
            y_trend = poly_func(x_trend)
            fig.add_trace(go.Scatter(x=x_trend, y=y_trend, mode='lines', name='Regression Curve',
                                     line=dict(color='#FFFFFF', width=3, dash='solid')))
    fig.update_layout(title="System Efficiency Profile", template="plotly_dark", height=350,
                      margin=dict(l=0, r=0, t=40, b=0), xaxis_title="PWM Signal (us)", yaxis_title="Efficiency (g/W)")
    return fig


# ==========================================
# 6. MAIN TELEMETRY LOOP
# ==========================================
if st.session_state.is_running:
    try:
        # OPEN SERIAL WITHOUT RESETTING THE ESP32
        ser = serial.Serial()
        ser.port = serial_port
        ser.baudrate = baud_rate
        ser.timeout = 0.1
        ser.setDTR(False)  # <--- Critical: Prevents ESP32 hardware reset on UI interaction
        ser.setRTS(False)  # <--- Critical: Prevents ESP32 hardware reset on UI interaction
        ser.open()

        # Build and send JSON Command Downlink
        cmd_payload = {
            "pwm": target_pwm,
            "cal": cal_factor,
            "tare": 1 if tare_requested else 0
        }
        ser.write((json.dumps(cmd_payload) + '\n').encode())

        # --- Initialize MQTT Broker for Ansys ---
        mqtt_client = mqtt.Client(mqtt.CallbackAPIVersion.VERSION2, "DEP_Gateway")
        try:
            mqtt_client.connect("localhost", 1883)
            mqtt_client.loop_start()  # Starts network loop in background
        except Exception as mqtt_err:
            st.sidebar.warning("⚠️ MQTT Broker not running on localhost:1883")
        # --------------------------------------------------

        last_ui_update = time.time()

        while st.session_state.is_running:
            try:
                line = ser.readline().decode('utf-8').strip()
                if line:
                    payload = json.loads(line)

                    # --- Publish Live Data to Ansys Twin Builder ---
                    try:
                        mqtt_client.publish("evtol/rotor1/telemetry", json.dumps(payload))
                    except NameError:
                        pass  # Ignore if MQTT failed to connect earlier
                    # ---------------------------------------------------------

                    if st.session_state.start_millis is None:
                        st.session_state.start_millis = payload['time']

                    time_s = (payload['time'] - st.session_state.start_millis) / 1000.0
                    eff = payload['thrust_g'] / payload['power_W'] if payload['power_W'] > 0.5 else 0.0

                    new_data = {
                        'time_s': time_s, 'thrust_g': payload['thrust_g'], 'voltage': payload['voltage'],
                        'current_A': payload['current_A'], 'power_W': payload['power_W'],
                        'pwm': payload['pwm'], 'efficiency_g_W': eff
                    }
                    new_row = pd.DataFrame([new_data])

                    st.session_state.data = pd.concat([st.session_state.data, new_row], ignore_index=True)
                    if len(st.session_state.data) > 200:
                        st.session_state.data = st.session_state.data.iloc[1:]

            except json.JSONDecodeError:
                pass

            current_time = time.time()
            if current_time - last_ui_update > 0.2 and not st.session_state.data.empty:
                df = st.session_state.data

                metric_thrust.metric("Thrust (g)", f"{df['thrust_g'].iloc[-1]:.1f}")
                metric_power.metric("Power (W)", f"{df['power_W'].iloc[-1]:.1f}")
                metric_current.metric("Current (A)", f"{df['current_A'].iloc[-1]:.2f}",
                                      f"{df['voltage'].iloc[-1]:.2f} V")
                metric_efficiency.metric("Efficiency (g/W)", f"{df['efficiency_g_W'].iloc[-1]:.2f}")

                # --- EDITED CODE: Added unique dynamic keys to prevent Streamlit ID collisions ---
                transient_chart.plotly_chart(get_transient_fig(df), use_container_width=True,
                                             key=f"transient_{current_time}")
                electrical_chart.plotly_chart(get_electrical_fig(df), use_container_width=True,
                                              key=f"elec_{current_time}")
                thrust_curve_chart.plotly_chart(get_thrust_curve_fig(df), use_container_width=True,
                                                key=f"thrust_{current_time}")
                efficiency_curve_chart.plotly_chart(get_efficiency_curve_fig(df), use_container_width=True,
                                                    key=f"eff_{current_time}")
                # ---------------------------------------------------------------------------------

                last_ui_update = current_time

            time.sleep(0.01)

    except Exception as e:
        st.error(f"Serial Connection Failed: {e}")
        st.session_state.is_running = False
        # --- NEW CODE: Reset connection state if crash occurs ---
        st.session_state.is_connected = False
        # --------------------------------------------------------
