MechEngineerDhruv/dep-evtol-digital-twin/(commit log)

2026-10-29 Add files via upload
    Full Assembly Rendring
2026-10-29 Rename Full Assembly Rendring .jpg to Full-Assembly-Rendring .jpg
2026-10-29 Rename Full-Assembly-Rendring .jpg to Full-Assembly-Rendring.jpg
2026-10-29 Add files via upload
    Updated Full Assembly with BLDC Motor and 1045 Propeller
2026-10-30 Add files via upload
    Updated CAD Drawings and Rendering
